KobbyTe/smart-attendance-deck/renders/section_keypad.png

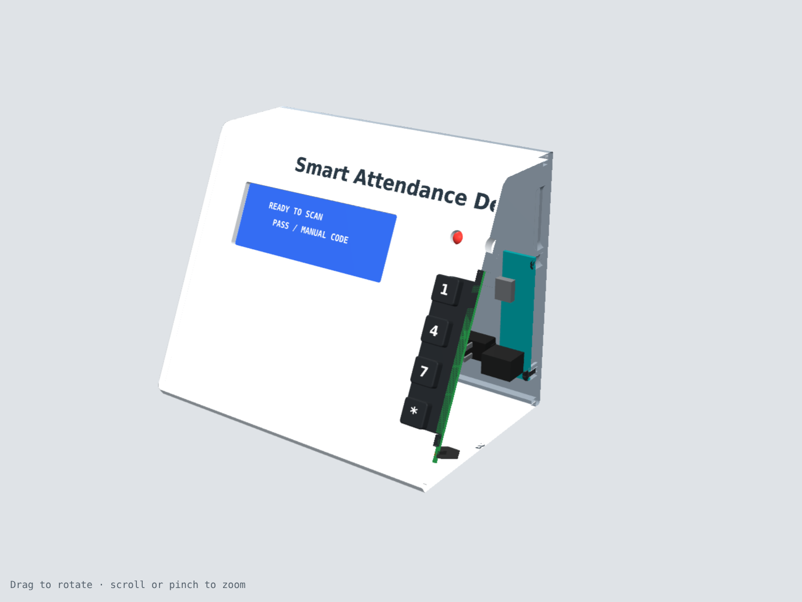
renders/section_keypad.png
