KobbyTe/smart-attendance-deck/cad/smart_attendance_deck_assembly_exploded.step

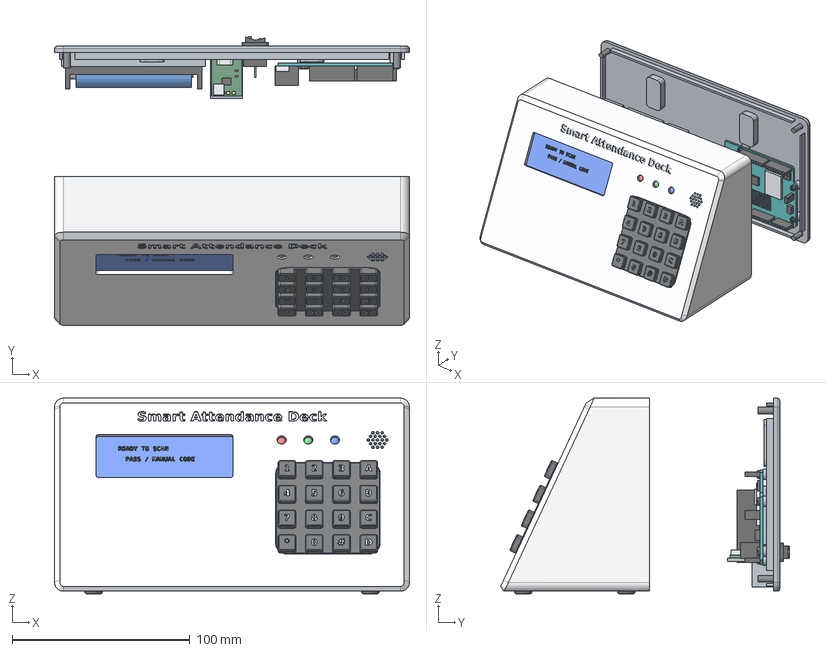
[picture p7: CAD file, 2026-10-29]
cad/smart_attendance_deck_assembly_exploded.step
200.0 x 162.6 x 110.3 mm
front_shell
back_cover
lcd_20x4_i2c_bezel
lcd_20x4_i2c_glass
lcd_20x4_i2c_text
lcd_20x4_i2c_pcb
lcd_20x4_i2c_black
lcd_20x4_i2c_pot
lcd_20x4_i2c_pins
rfid_rc522_pcb
rfid_rc522_ant
rfid_rc522_black
rfid_rc522_caps
rfid_rc522_pins
rfid_rc522_dupont
keypad_4x4_black
keypad_4x4_labels
keypad_4x4_pcb
keypad_4x4_pads
keypad_4x4_dupont
led_red_lens
led_red_legs
led_green_lens
led_green_legs
led_blue_lens
led_blue_legs
buzzer_body
buzzer_mark
buzzer_pins
screw_m3x6_lcd_1_steel x 4
rubber_foot_1_rubber x 4
insert_m4_1_brass x 4
arduino_uno_r4_wifi_pcb
arduino_uno_r4_wifi_black
arduino_uno_r4_wifi_metal
arduino_uno_r4_wifi_leds
screw_m25x6_arduino_1_steel x 4
battery_2x18650_holder
battery_2x18650_cells
battery_2x18650_metal
battery_2x18650_text
charge_board_2s_usbc_pcb
charge_board_2s_usbc_metal
charge_board_2s_usbc_black
charge_board_2s_usbc_leds
charge_board_2s_usbc_pads
power_switch_black
power_switch_mark
power_switch_terms
screw_m4x12_1_steel x 4
