KobbyTe/smart-attendance-deck/cad/components/led5_red.step

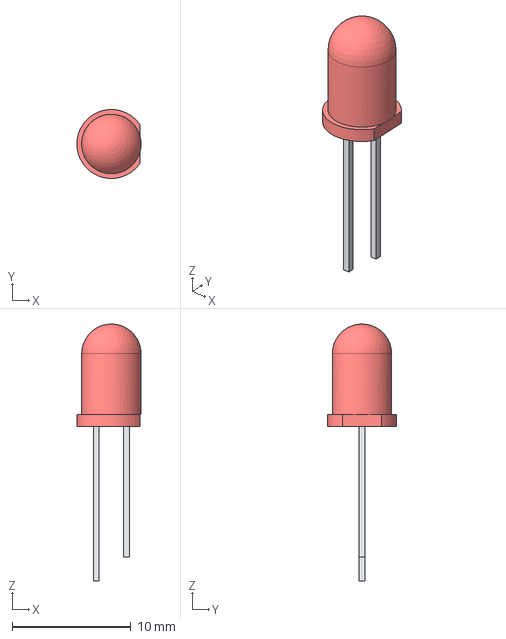
[picture p9: CAD file, 2026-10-29]
cad/components/led5_red.step
5.39 x 5.80 x 21.6 mm
lens
legs
