KobbyTe/smart-attendance-deck/cad/parts/front_shell.step

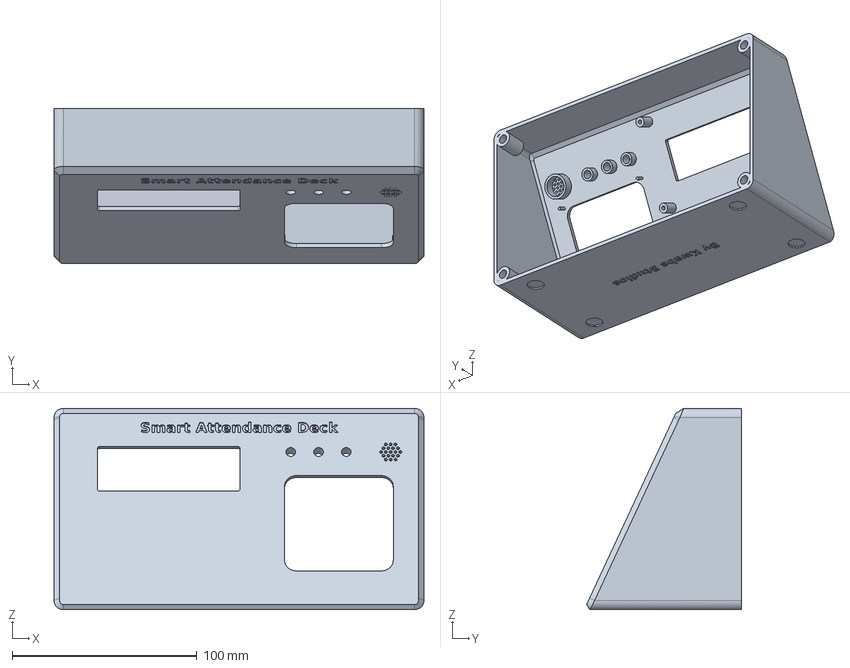
[picture p10: CAD file, 2026-10-29]
cad/parts/front_shell.step
200.0 x 83.7 x 108.8 mm
