KobbyTe/smart-attendance-deck/cad/parts/back_cover.step

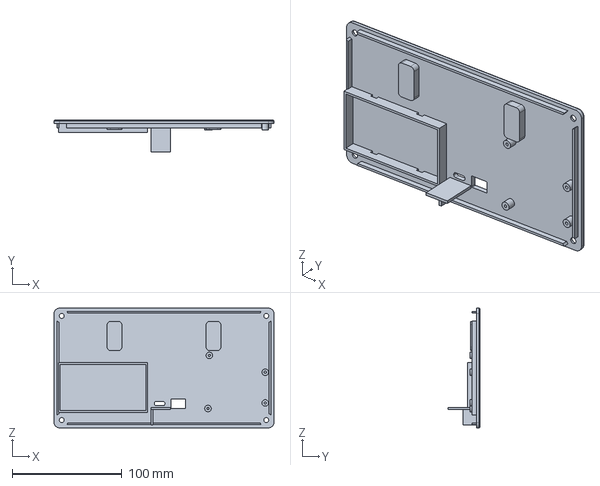
[picture p11: CAD file, 2026-10-29]
cad/parts/back_cover.step
200.0 x 29.5 x 108.8 mm
