KobbyTe/smart-attendance-deck/cad/components/rc522.step

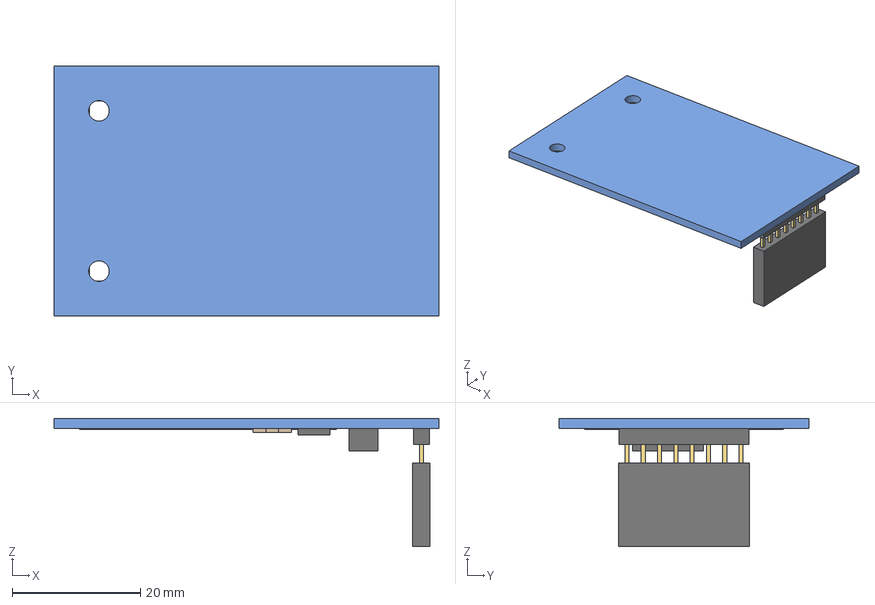
[picture p12: CAD file, 2026-10-29]
cad/components/rc522.step
60.0 x 39.0 x 20.0 mm
pcb
ant
black
caps
pins
dupont
