KobbyTe/smart-attendance-deck/cad/components/lcd2004_i2c.step

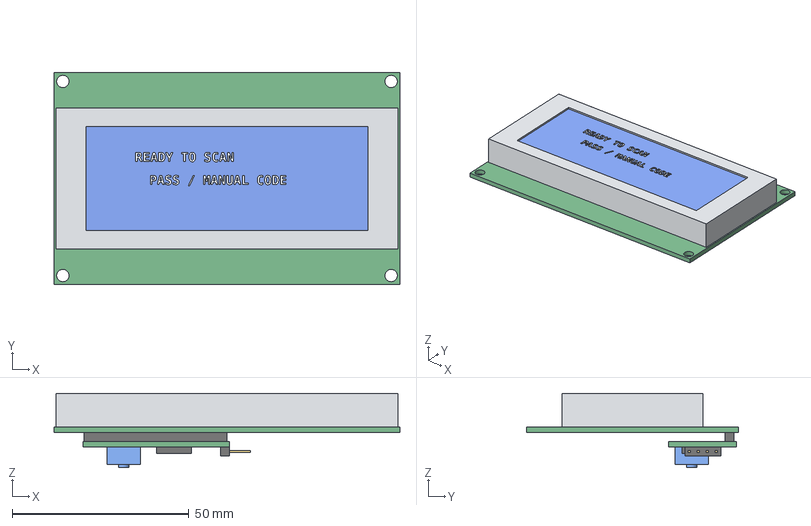
[picture p13: CAD file, 2026-10-29]
cad/components/lcd2004_i2c.step
98.0 x 60.0 x 21.0 mm
bezel
glass
text
pcb
black
pot
pins
