KobbyTe/smart-attendance-deck/cad/components/buzzer12.step

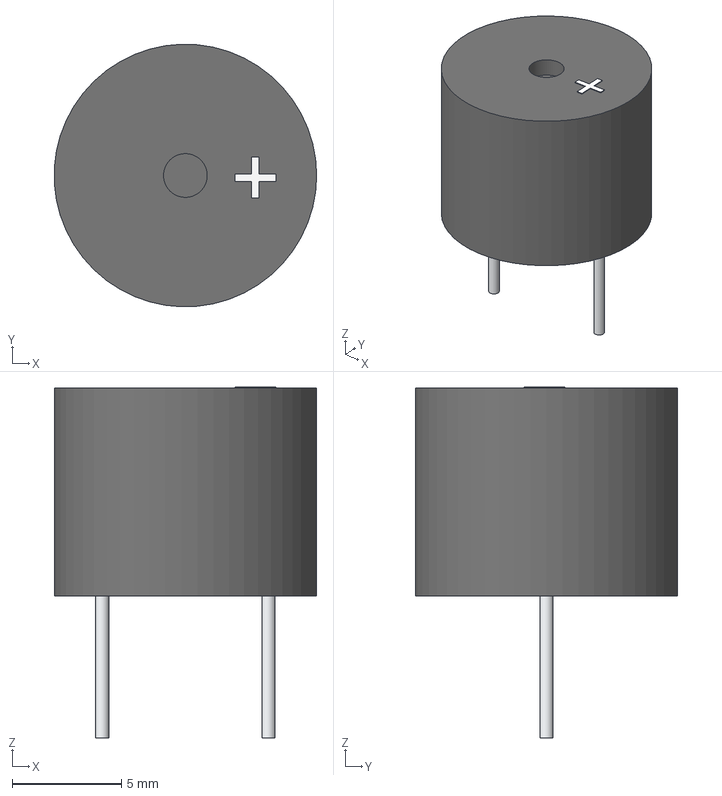
[picture p14: CAD file, 2026-10-29]
cad/components/buzzer12.step
12.0 x 12.0 x 16.0 mm
mark
pins
