KobbyTe/smart-attendance-deck/cad/components/rubber_foot.step

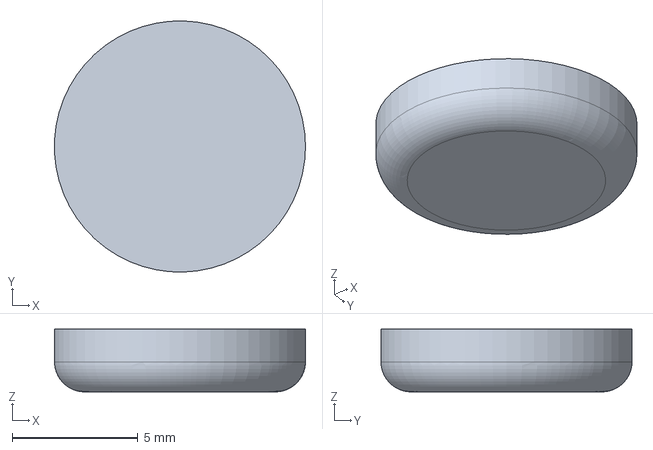
[picture p15: CAD file, 2026-10-29]
cad/components/rubber_foot.step
9.99 x 10.00 x 2.50 mm
