KobbyTe/smart-attendance-deck/cad/components/arduino_uno_r4_wifi.step

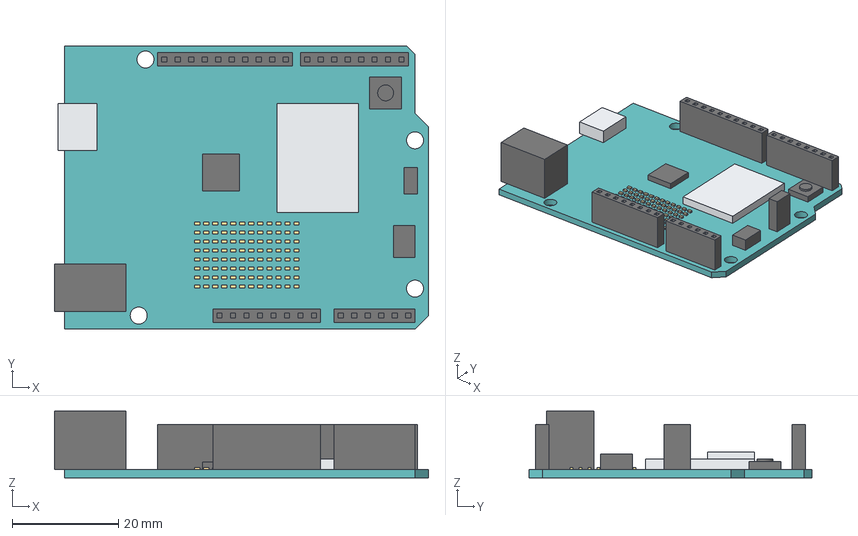
[picture p16: CAD file, 2026-10-29]
cad/components/arduino_uno_r4_wifi.step
70.5 x 53.3 x 12.6 mm
pcb
black
metal
leds
