KobbyTe/smart-attendance-deck/cad/components/rocker_kcd11.step

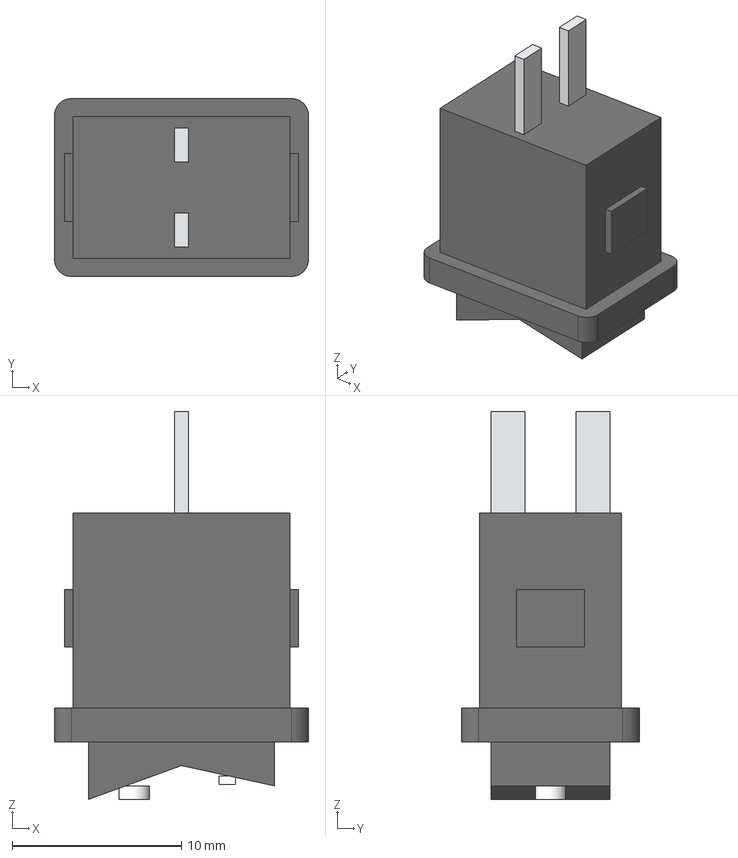
[picture p17: CAD file, 2026-10-29]
cad/components/rocker_kcd11.step
15.0 x 10.5 x 22.9 mm
black
mark
terms
