KobbyTe/smart-attendance-deck/cad/components/battery_2x18650.step

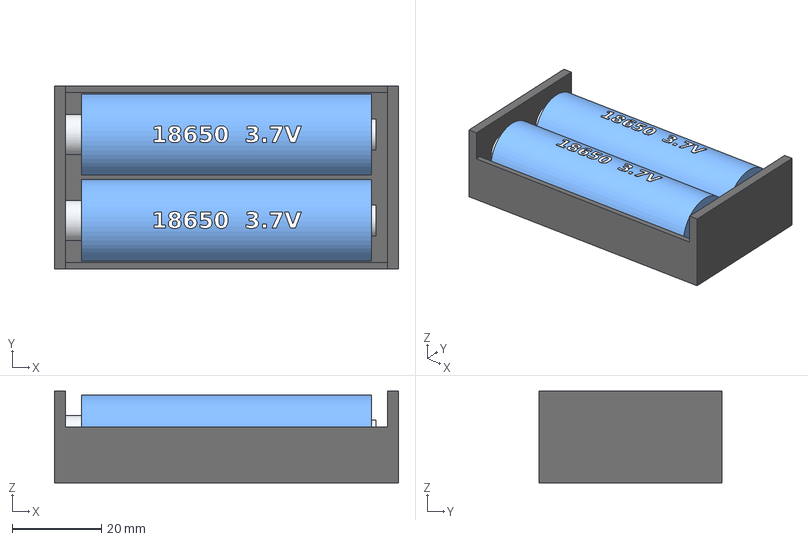
[picture p18: CAD file, 2026-10-29]
cad/components/battery_2x18650.step
77.0 x 41.0 x 20.5 mm
holder
cells
metal
text
