KobbyTe/smart-attendance-deck/cad/components/charge_board_2s.step

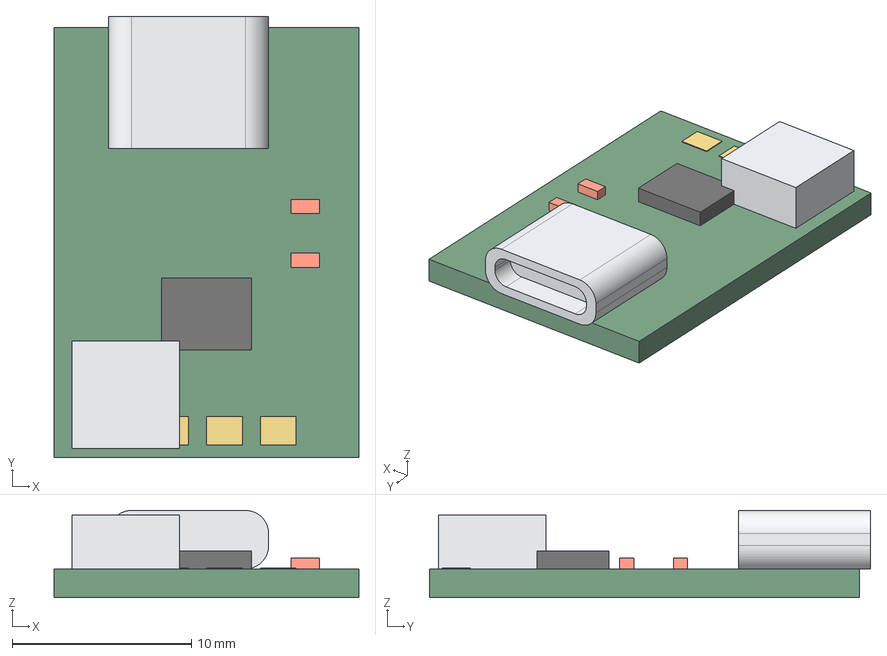
[picture p19: CAD file, 2026-10-29]
cad/components/charge_board_2s.step
17.0 x 24.6 x 4.86 mm
pcb
metal
black
leds
pads
