KobbyTe/smart-attendance-deck/cad/components/keypad_4x4_hard.step

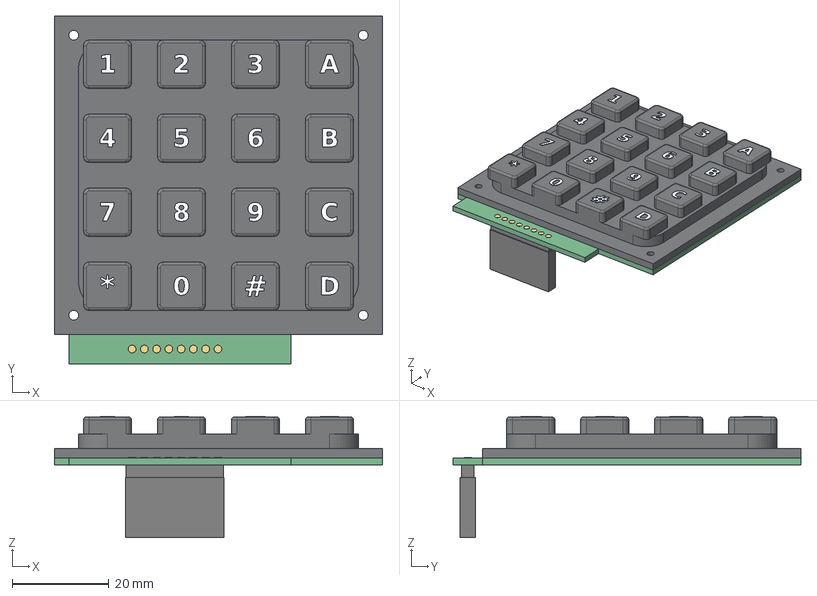
[picture p20: CAD file, 2026-10-29]
cad/components/keypad_4x4_hard.step
68.0 x 72.1 x 25.1 mm
black
labels
pcb
pads
dupont
