KobbyTe/smart-attendance-deck/cad/components/m4_insert.step

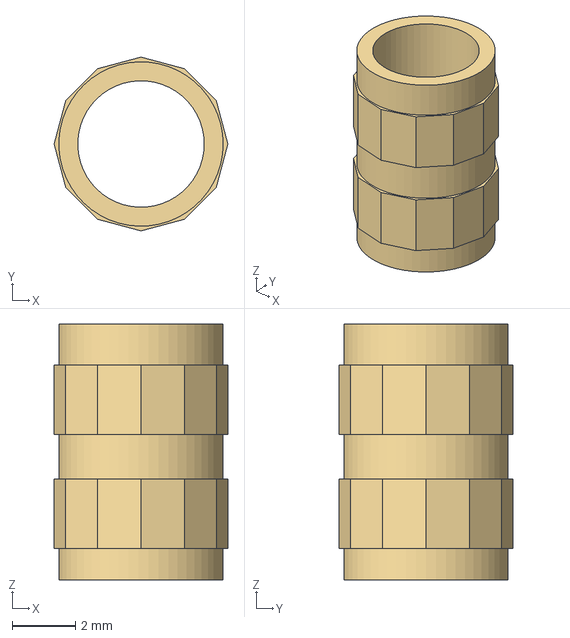
[picture p21: CAD file, 2026-10-29]
cad/components/m4_insert.step
5.50 x 5.50 x 8.10 mm
