KobbyTe/smart-attendance-deck/cad/components/m4x12_csk.step

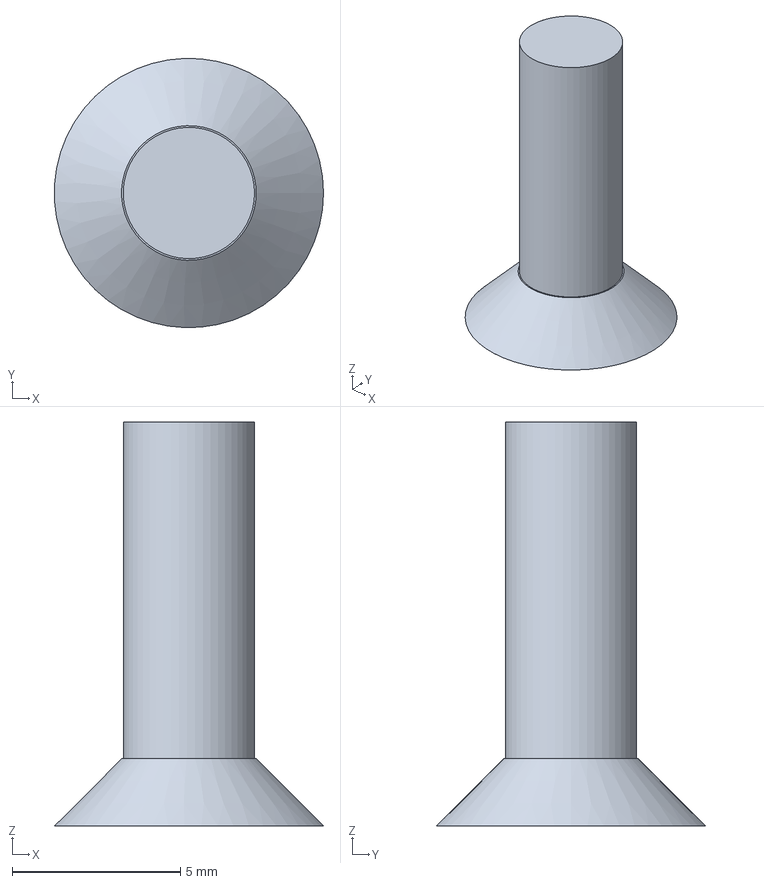
[picture p22: CAD file, 2026-10-29]
cad/components/m4x12_csk.step
7.99 x 8.00 x 12.0 mm
