KobbyTe/smart-attendance-deck/(list of files, cad)

Other CAD files:
cad/components/led5_green.step
cad/components/led5_blue.step
cad/components/m25x6_pan.step
cad/components/m3x6_pan.step
print/back_cover.stl
print/front_shell.stl
