KobbyTe/smart-attendance-deck/(commit log)

2026-10-29 Add full STEP assembly (assembled and exploded)
    [smart_attendance_deck_assembly.step, smart_attendance_deck_assembly_exploded.step]
2026-10-29 Add printable enclosure parts (STEP)
    [back_cover.step, front_shell.step]
2026-10-29 Add component models (STEP)
    [arduino_uno_r4_wifi.step, battery_2x18650.step, buzzer12.step, charge_board_2s.step, keypad_4x4_hard.step, lcd2004_i2c.step, led5_blue.step, led5_green.step]
2026-10-29 Add print-ready STL files
    [back_cover.stl, front_shell.stl]
